roland86-op/Pelacak-Kapal-Pompong/README.md

# Pelacak-Kapal-Pompong
Pelacak Kapal Pompong dengan komunikasi satu arah menggunakan GPS dan LoRa
